enwi/LED-Christmas-Tree/README.md

# LED-Christmas-Tree
Info &amp; documentation of LED Christmas Tree Kit, a WiFi enabled Christmas Tree Soldering Kit made up of 13x APA106-F5 digitally adressable LEDs.



## Feature overview
 - 13x adressable APA106-F5 LEDs
 - Pushbutton
 - WiFi enabled (ESP8266 D1 Mini)
 - 8 different effects + effect cycling
 - Brightness control
 - Effect speed control
 - 8 different color palettes
 - WebUI
    - Change effects
    - Change color palettes
    - Change brightness
    - Change effect speed
    - Control wifi settings
    - Upload OTA updates

## Where to buy

You can get [this kit](https://www.tindie.com/products/enwi/wifi-enabled-addressable-led-christmas-tree-kit/) on my [tindie store](https://www.tindie.com/stores/enwi/#store-section-products)

## Getting started
For build instructions have a look at the [Soldering Guide](https://github.com/enwi/LED-Christmas-Tree/blob/main/soldering.md)

For uploading/updating the software have a look at the [Software Guide](https://github.com/enwi/LED-Christmas-Tree/blob/main/software.md)

There are also two videos (one English one German), which show how to build a Christmas Tree

Video English (https://www.youtube.com/watch?v=GiBtM_6d54U)

Video German (https://www.youtube.com/watch?v=HssEsnOPAMU)

## About
See the about section [here](https://github.com/enwi/LED-Christmas-Tree/blob/main/about.md)
