enwi/LED-Christmas-Tree/images/kit.JPG

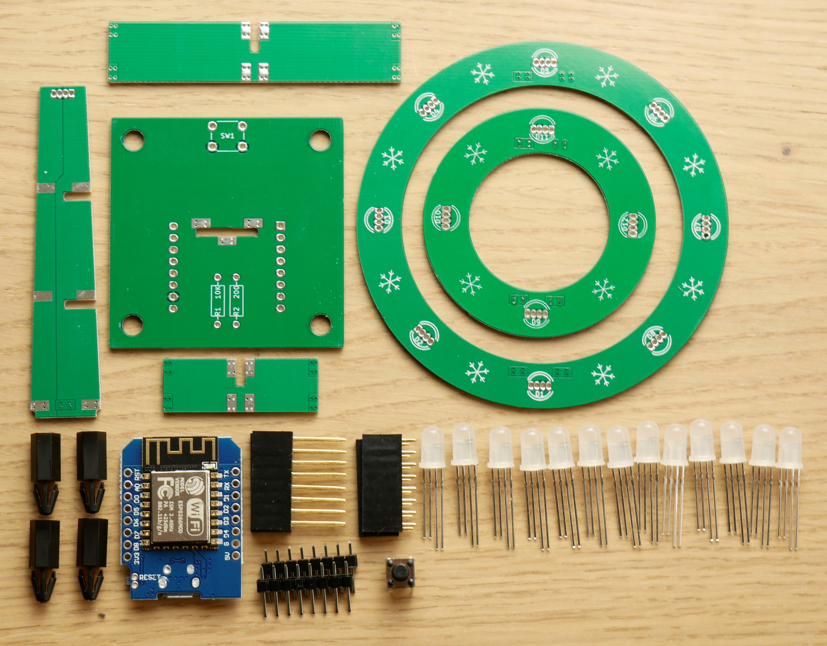
images/kit.JPG
