enwi/LED-Christmas-Tree/soldering.md

# Soldering Guide
Soldering/Putting the Christmas Tree PCB together is pretty simple, since there are not so many steps.

## 1. Assemble lower ring
1. Get the lower/larger branch and ring PCBs.
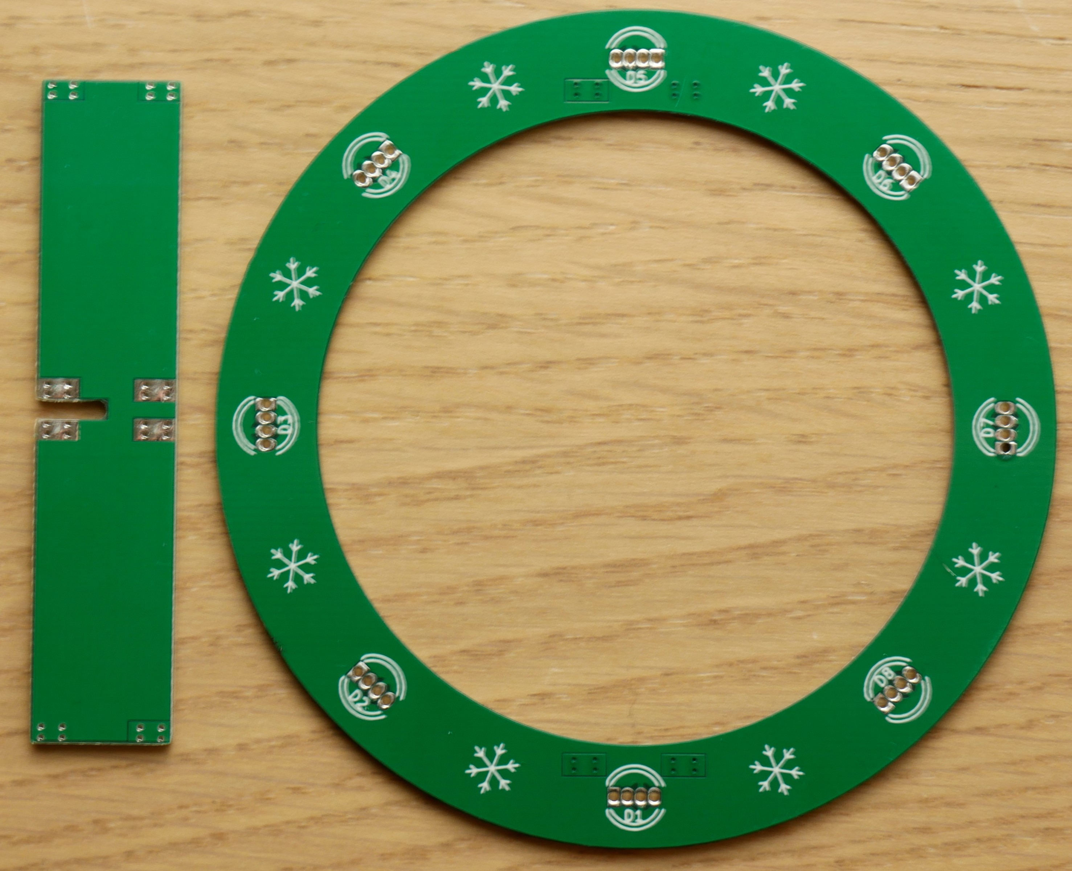
[picture p2: images/large_ring.JPG]


2. Flip the PCBs over and align the two arrows as shown in the picture.
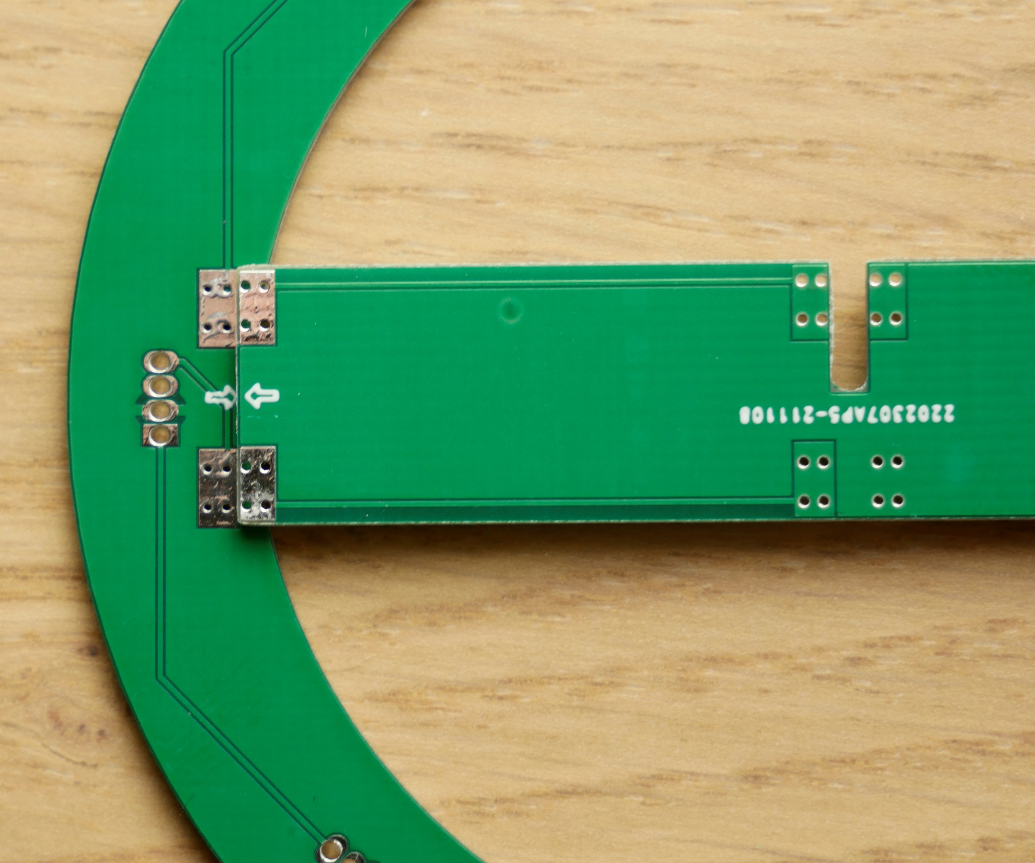
[picture p3: images/large_ring_aligned.JPG]


3. Solder the aligned pads of the two PCBs together.
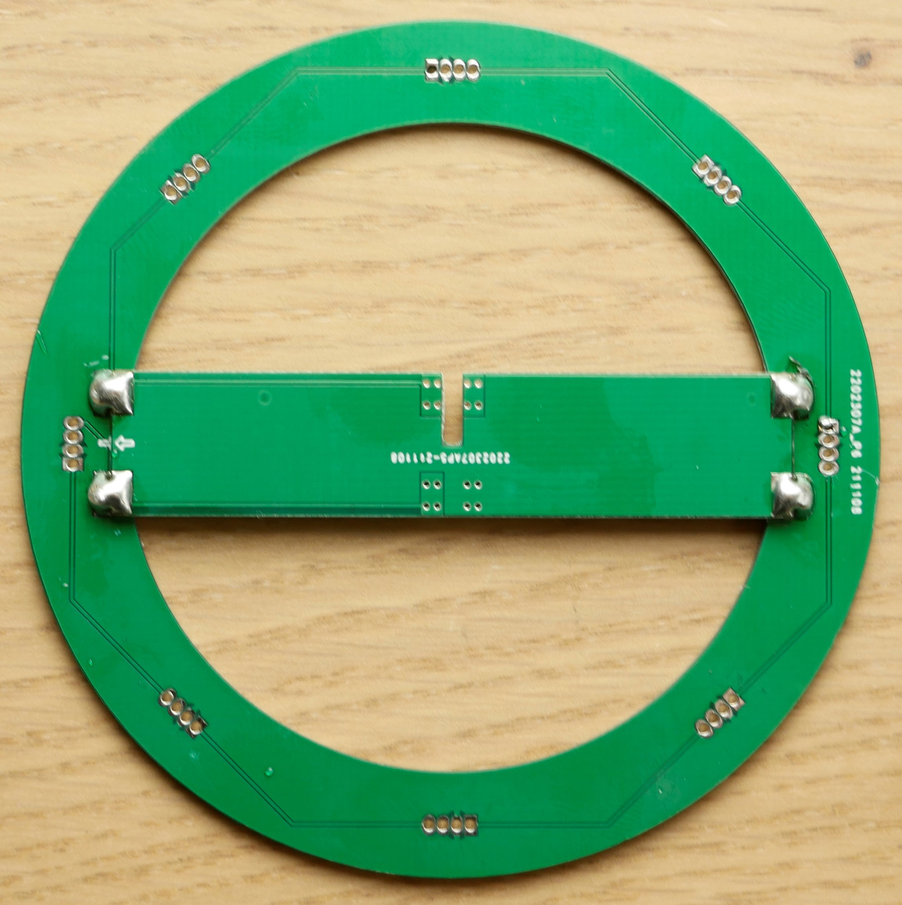
[picture p4: images/large_ring_soldered.JPG]


4. Get 8 LEDs.
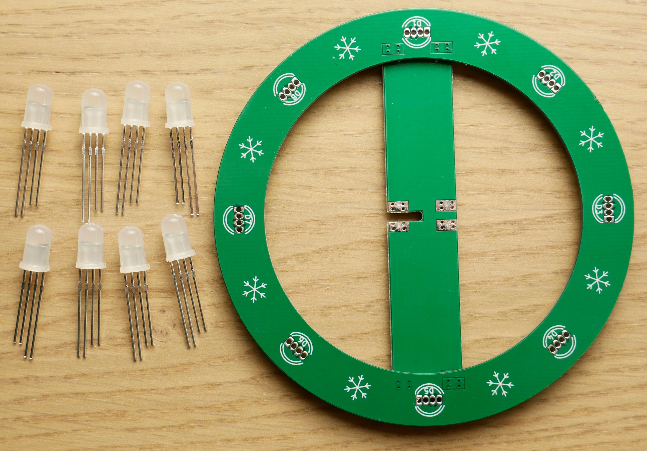
[picture p5: images/large_ring_leds.JPG]


5. Insert the LEDs as shown in the picture and marked on the PCB.
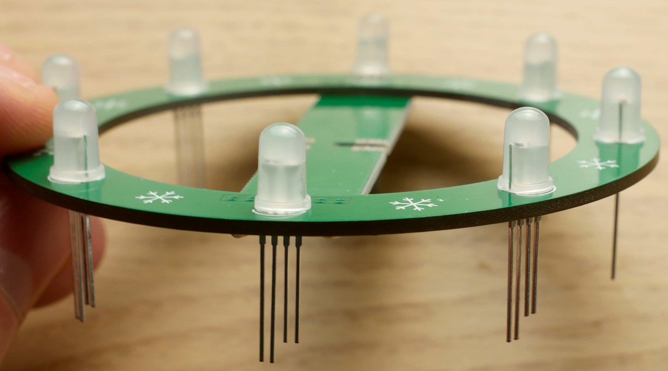
[picture p6: images/large_ring_leds_inserted.JPG]


6. Flip the ring over.
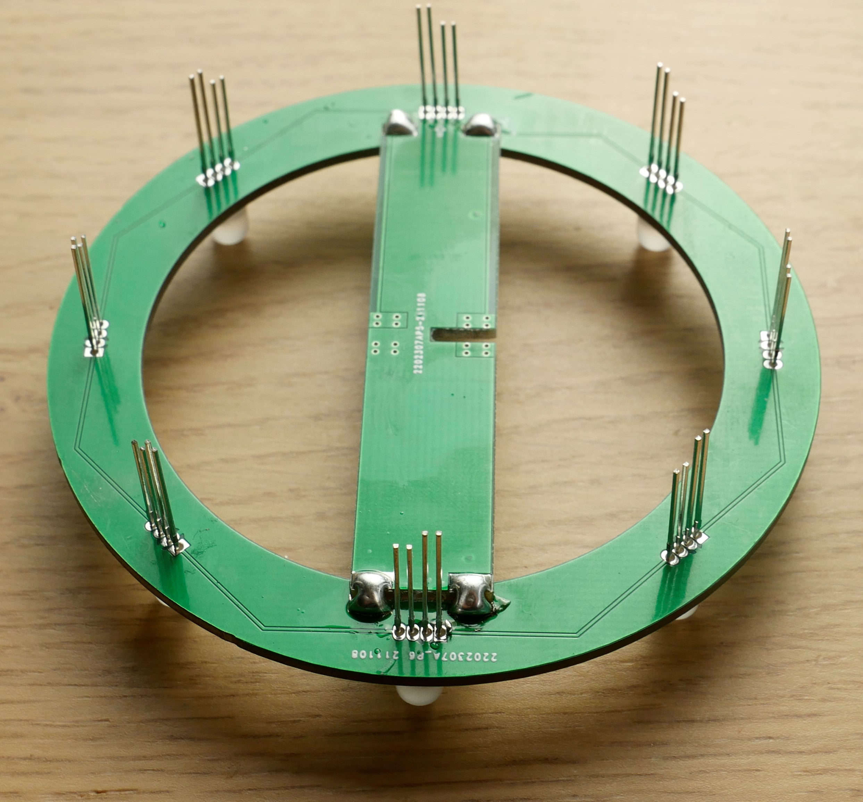
[picture p7: images/large_ring_leds_flipped.JPG]


7. Solder the LEDs and break/snip off their legs.
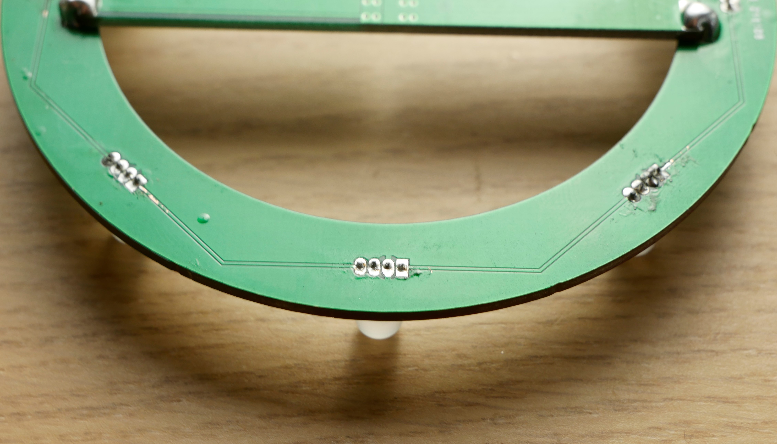
[picture p8: images/large_ring_leds_snipped.JPG]


## 2. Assemble upper ring
Repeat the steps of `1. Assemble lower ring` with the upper/smaller branch and ring PCBs.

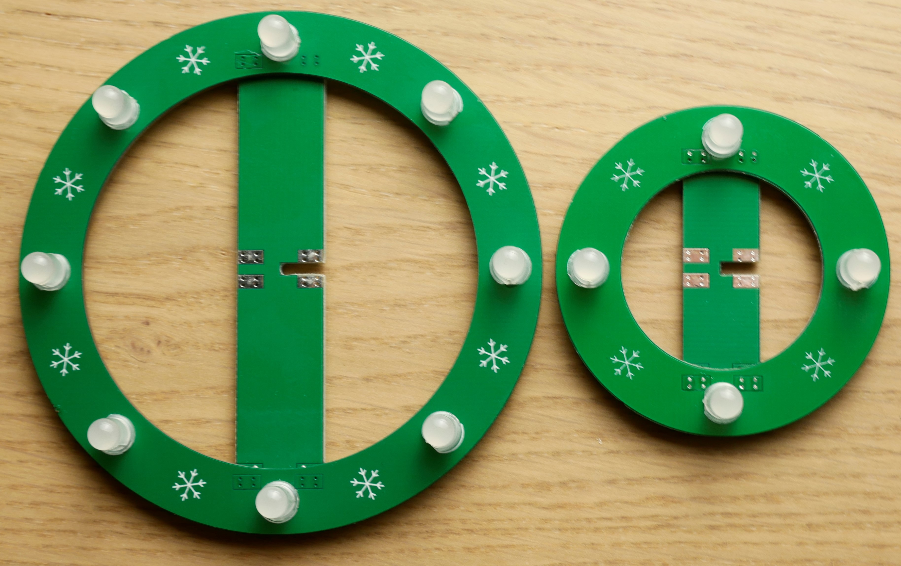
[picture p9: images/rings_assembled.JPG]


## 3. Assemble base plate
1. Get the base plate, the switch as well as the 10k and 200 ohm resistors.
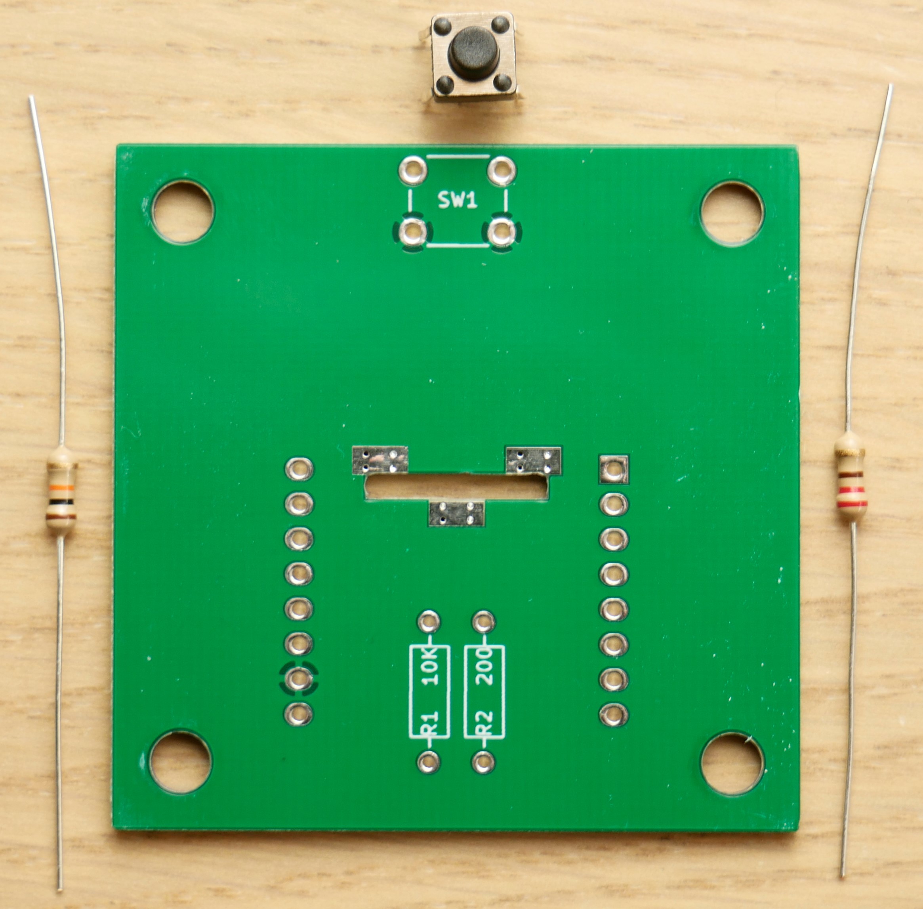
[picture p10: images/base.JPG]


2. Insert the components as marked on the PCB and solder them.
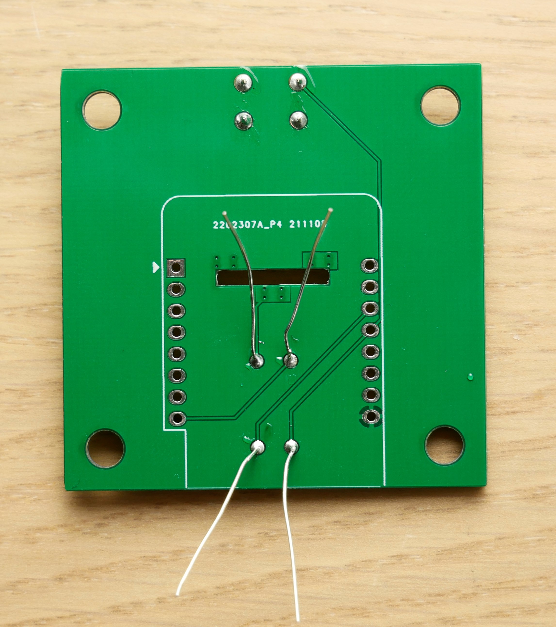
[picture p11: images/base_soldered.JPG]


3. Break/Snip off the legs of the components.
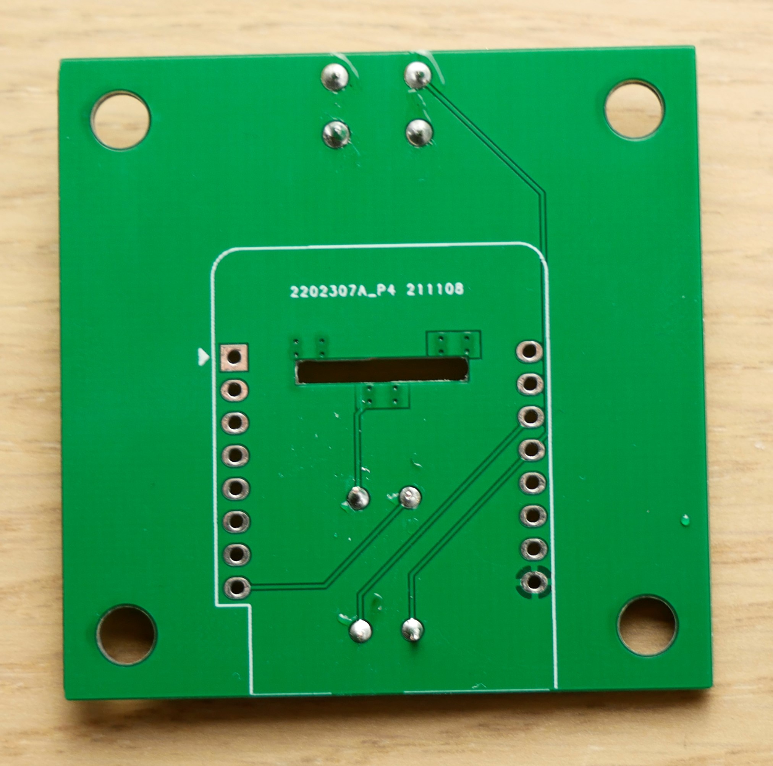
[picture p12: images/base_snipped.JPG]


4. Get the ESP8266 D1 Mini and two pin headers.
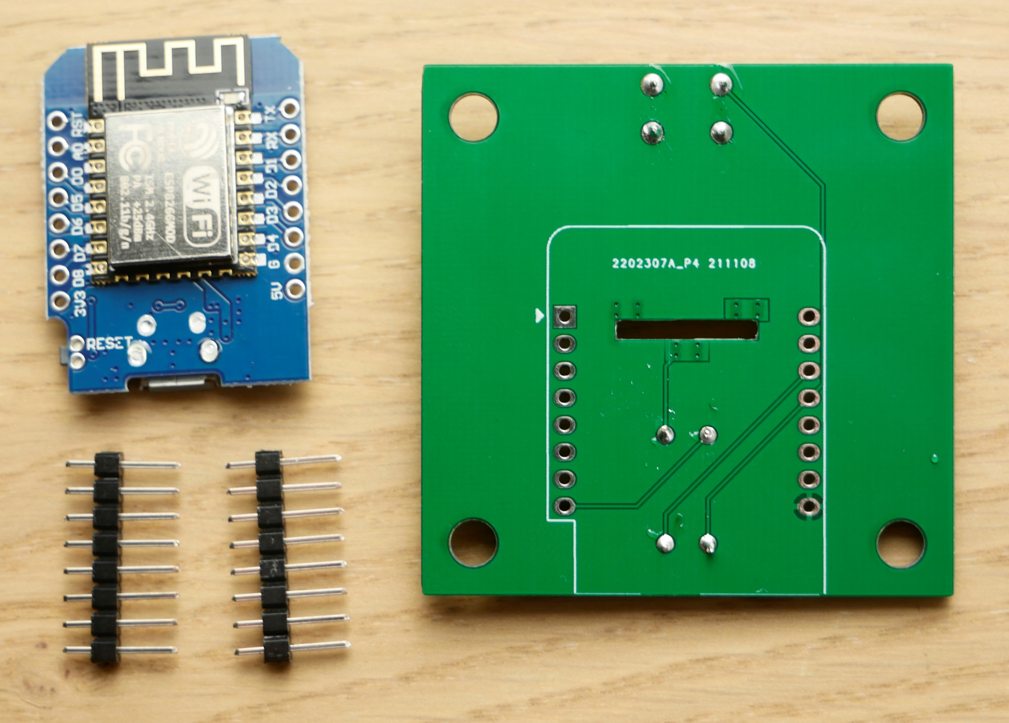
[picture p13: images/base_esp.JPG]


5. Insert the headers as seen in the picture on the bottom side (the one with the ESP8266 D1 Mini outline) of the PCB.
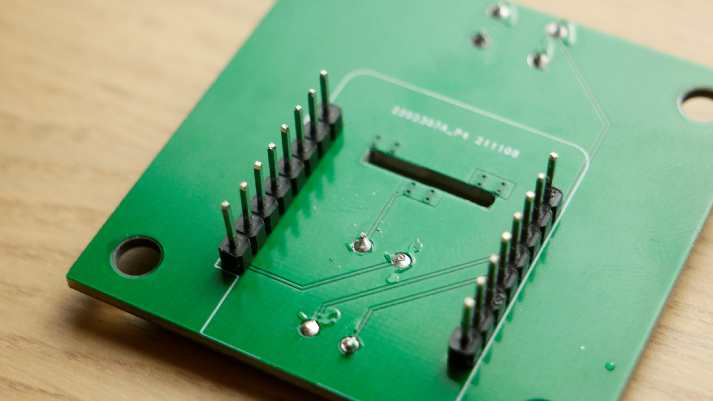
[picture p14: images/base_esp_headers.JPG]


6. Insert ESP8266 D1 Mini as seen in the picture.
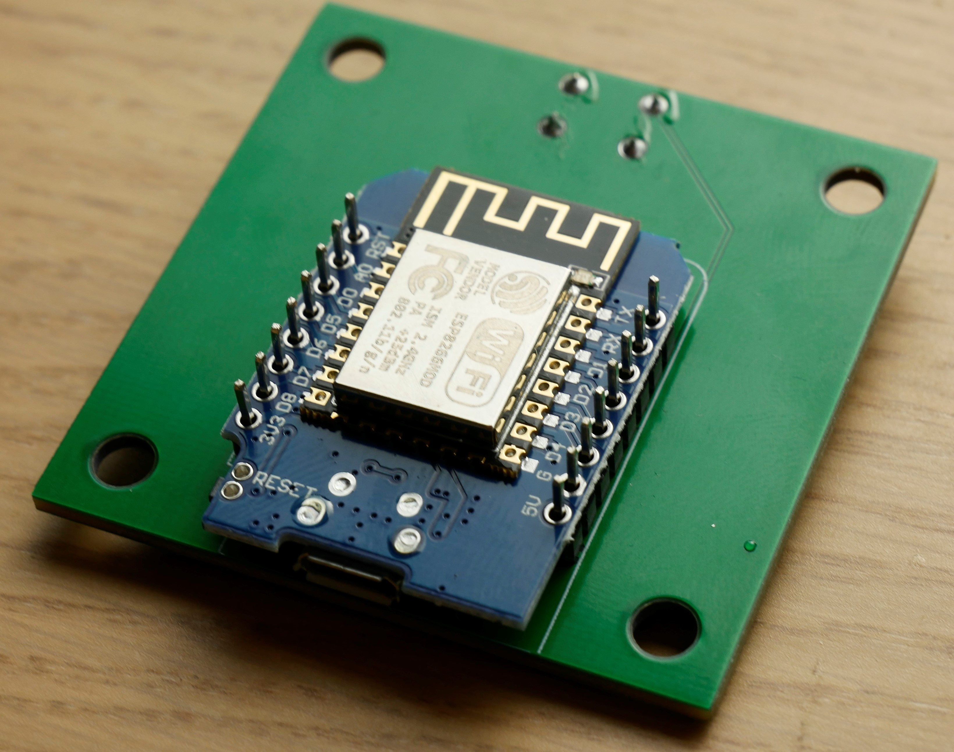
[picture p15: images/base_esp_headers_esp.JPG]


7. Flip the PCB over and solder the headers from the top.
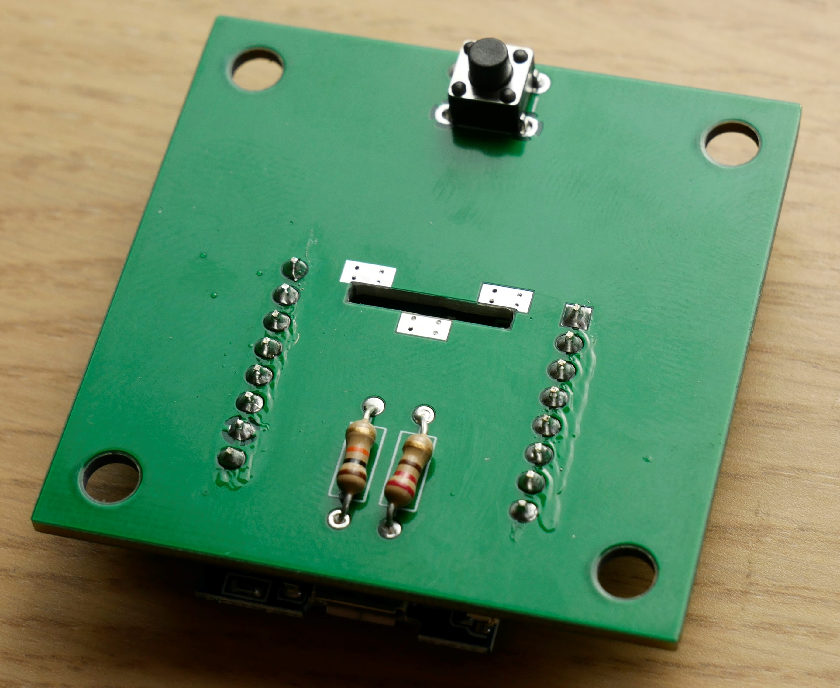
[picture p16: images/base_esp_headers_soldered.JPG]


8. Flip the PCB again and solder the ESP from the bottom while making sure that the Micro-USB does not touch the leads of the resistors.
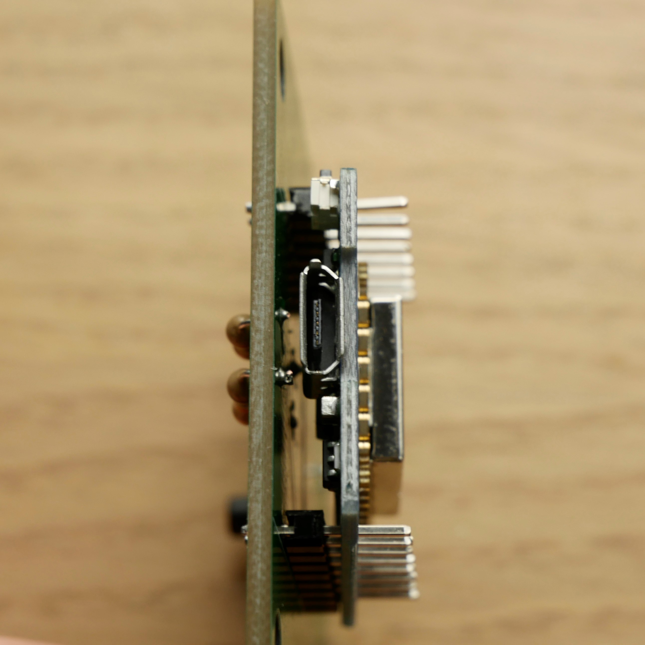
[picture p17: images/base_esp_clearance.JPG]

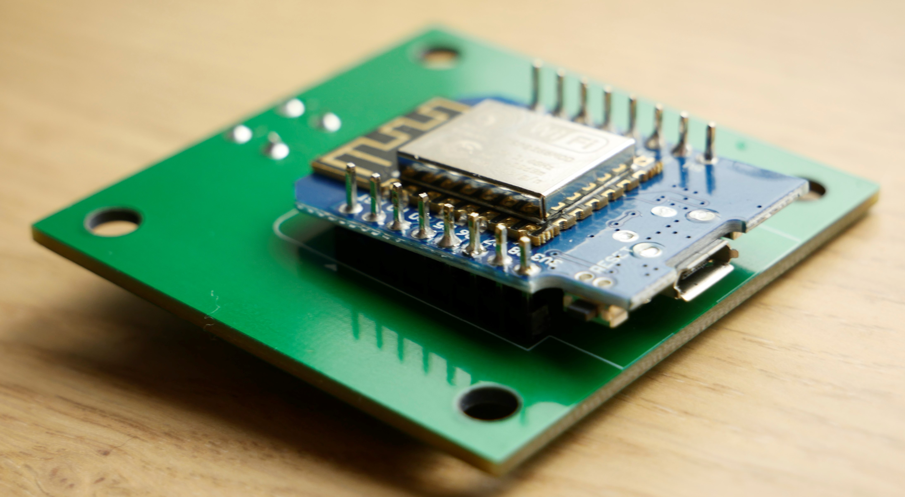
[picture p18: images/base_esp_soldered.JPG]


9. Get the plastic PCB spacers/standoffs.
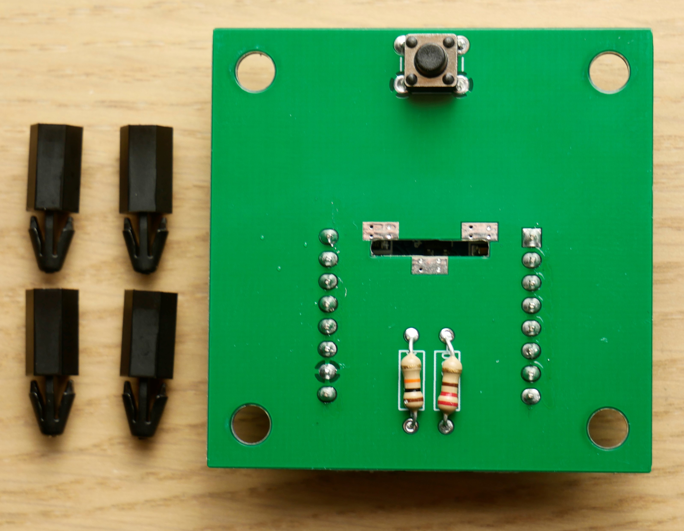
[picture p19: images/base_spacers.JPG]


10. Insert the PCB spacers/standoffs into the PCB from the bottom.
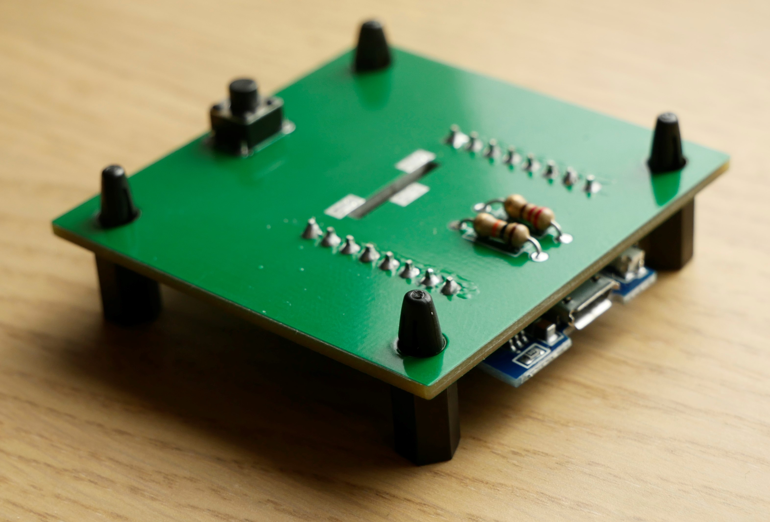
[picture p20: images/base_spacers_inserted.JPG]


## 4. Assemble tree
1. Get the tree trunk PCB.
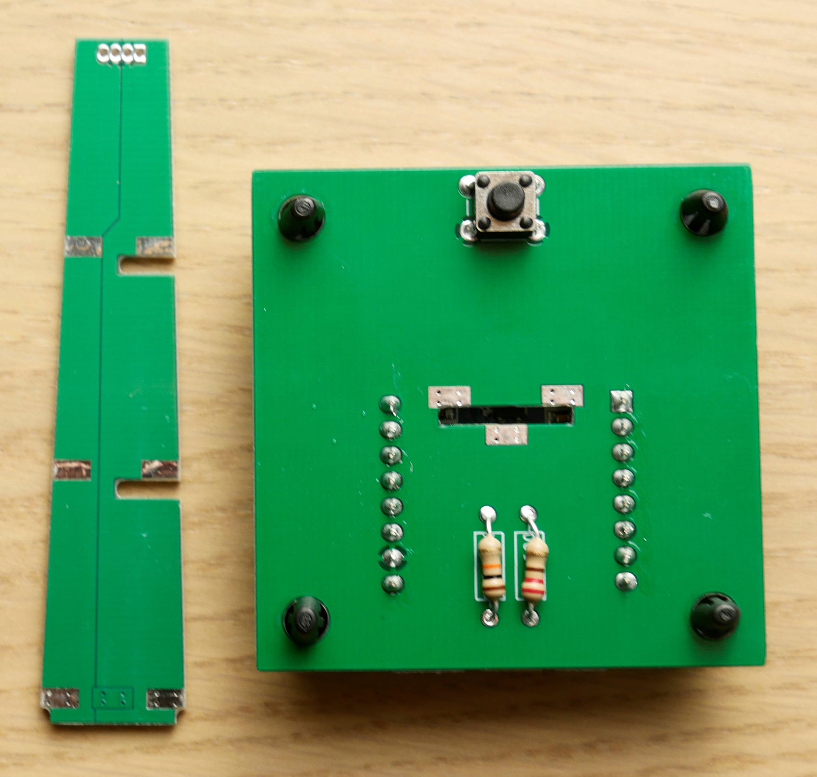
[picture p21: images/base_trunk.JPG]


2. Insert the trunk PCB into the slot of the base PCB while making sure the solder pads align.
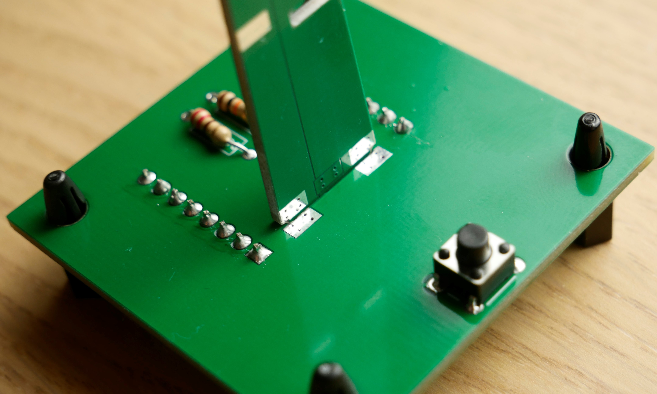
[picture p22: images/base_trunk_inserted.JPG]


3. Solder the pads of the trunk and base PCBs together while making sure the trunk is straight.
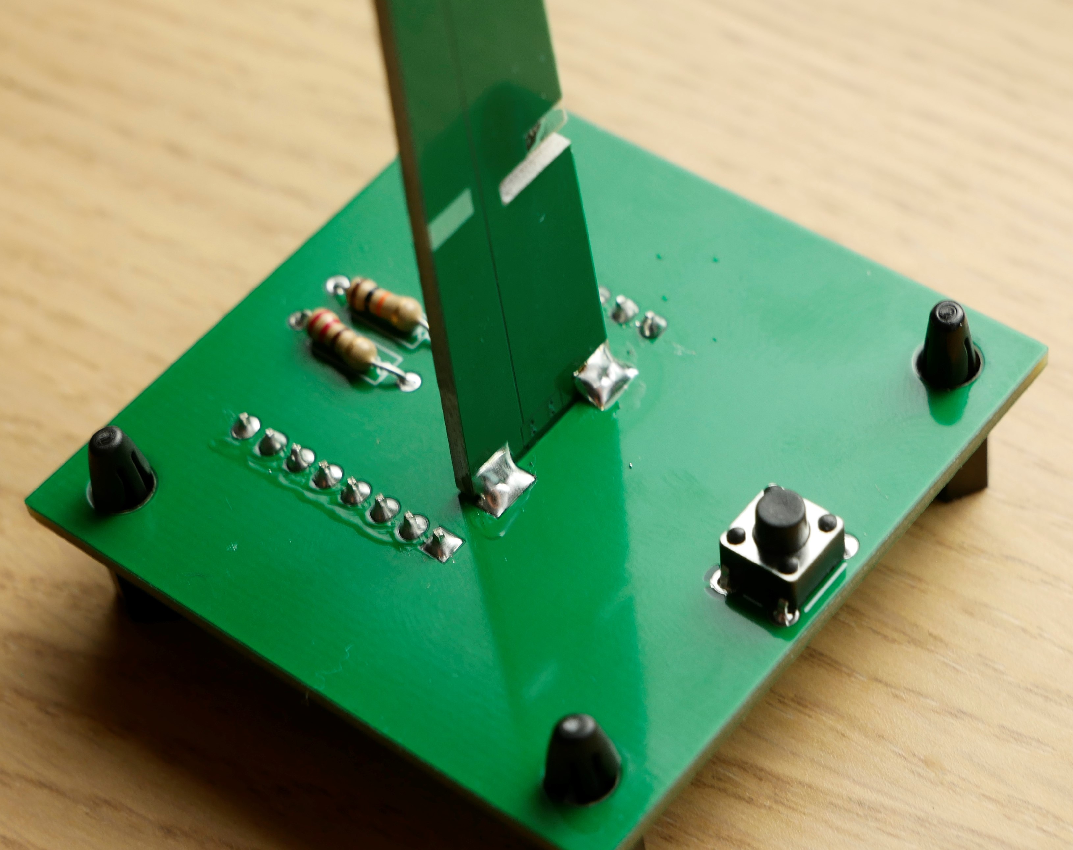
[picture p23: images/base_trunk_soldered.JPG]


4. Get the lower/larger ring and slide the branch into the trunk.
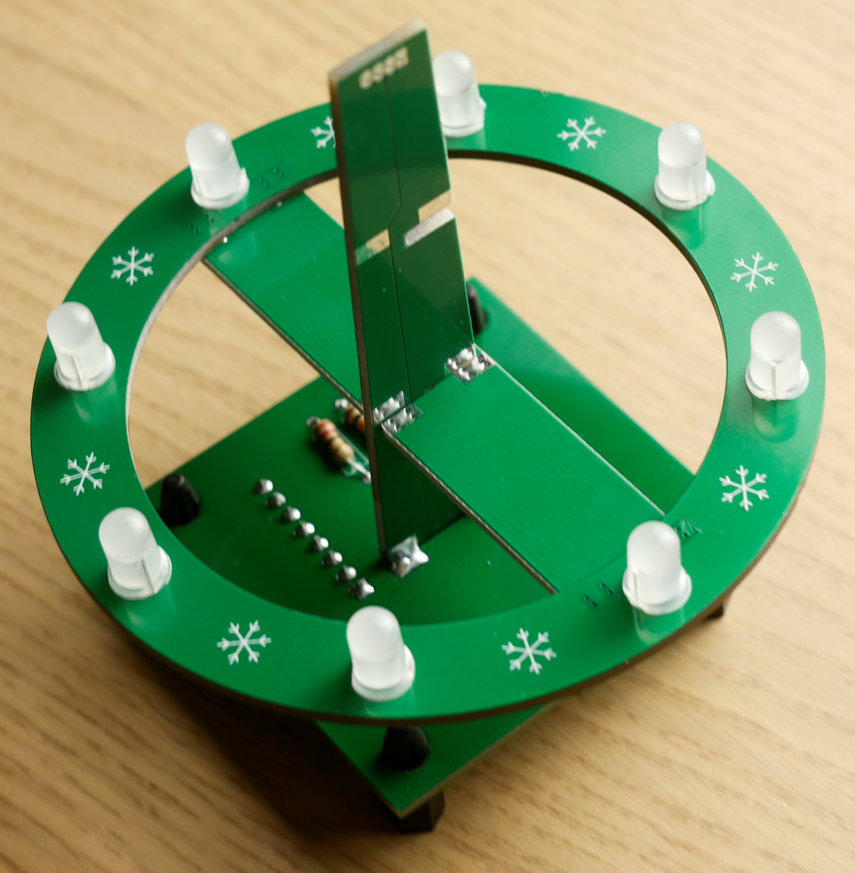
[picture p24: images/base_trunk_lower.JPG]


5. Solder the pads of the branch and the trunk PCBs together while making sure the lower/larger ring is level.
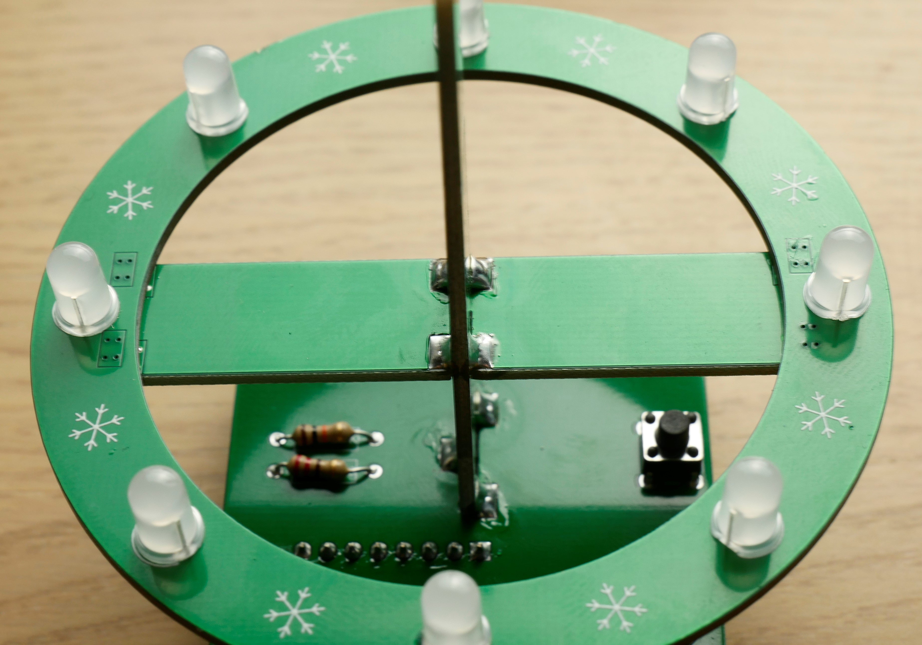
[picture p25: images/base_trunk_lower_soldered.JPG]


6. Repeat steps 4. and 5. for the upper/smaller ring.
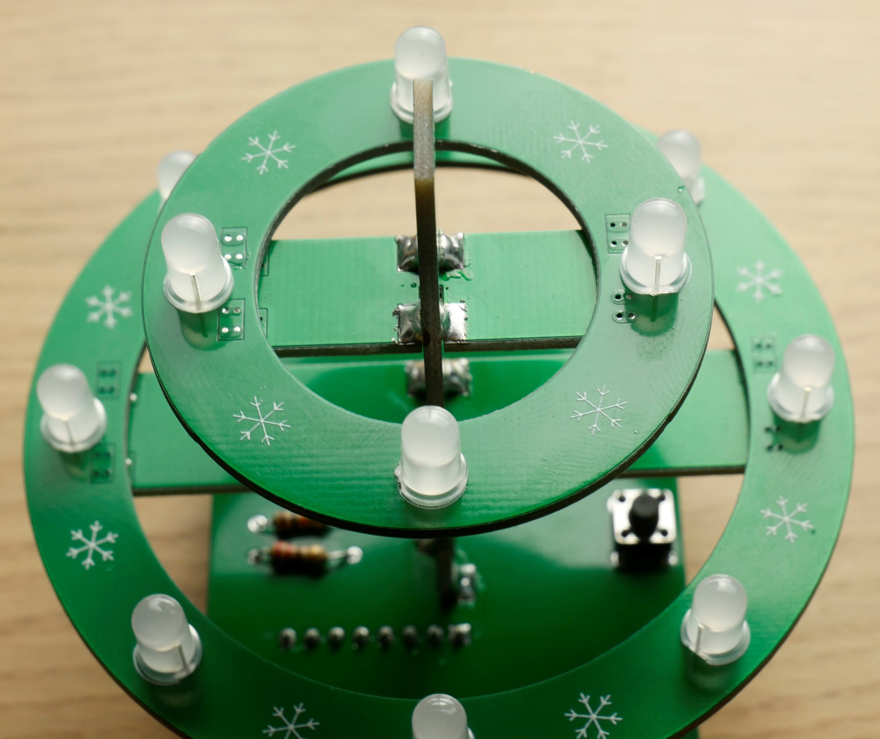
[picture p26: images/base_trunk_upper_soldered.JPG]


7. Get the last LED and insert it into the trunk PCB while leaving some space.
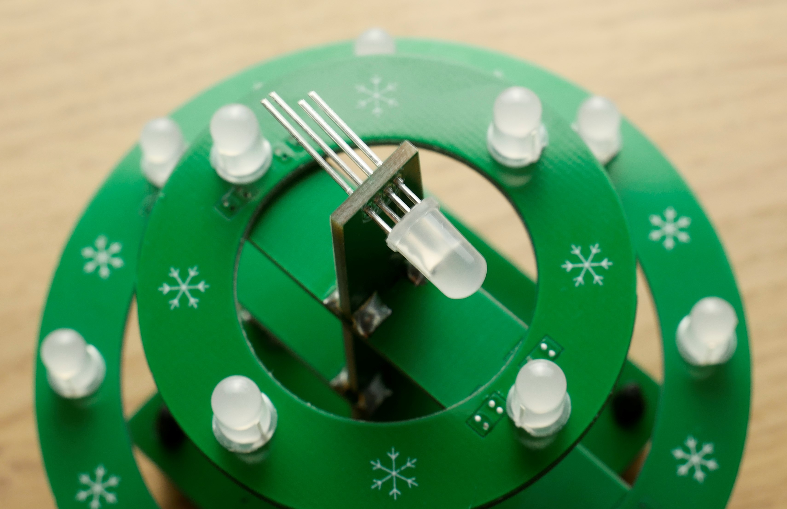
[picture p27: images/base_trunk_tip.JPG]


8. Bent the LED upwards and solder it in place.
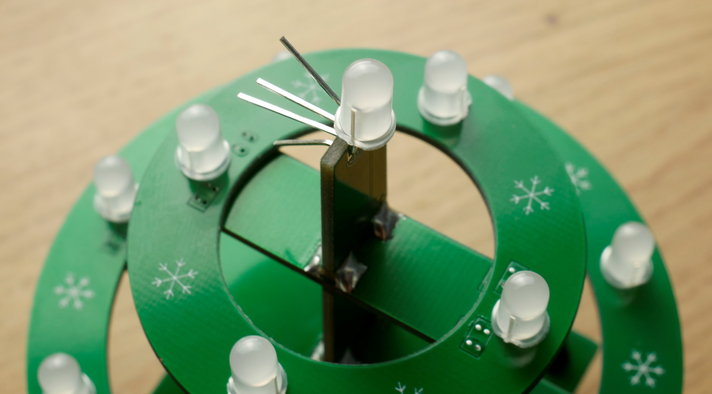
[picture p28: images/base_trunk_tip_soldered.JPG]


9. Break/Snip off the legs of the LED.
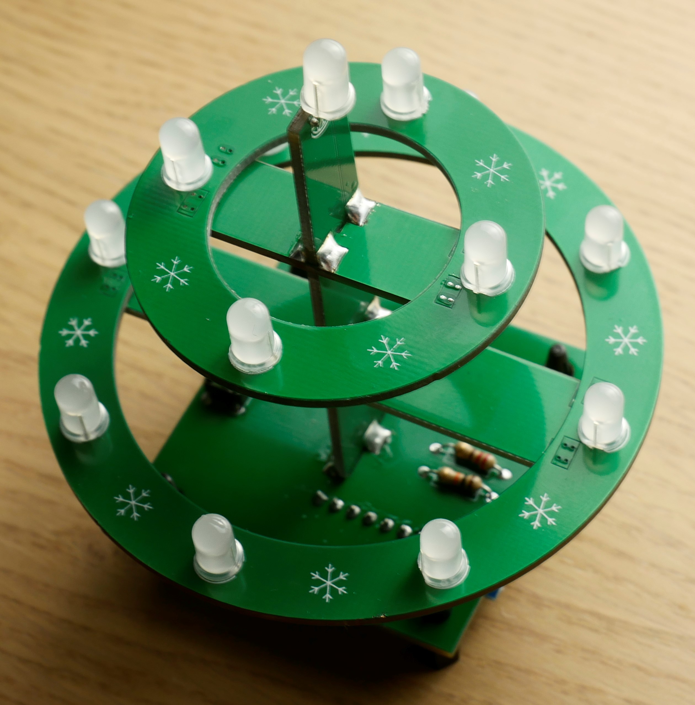
[picture p29: images/base_trunk_tip_snipped.JPG]


10. Congratulations you finished building the Christmas Tree :christmas_tree:. Now plug in the ESP8266 to your PC, upload the software described in the [Software Guide](https://github.com/enwi/LED-Christmas-Tree/blob/main/software.md) and enjoy :tada:
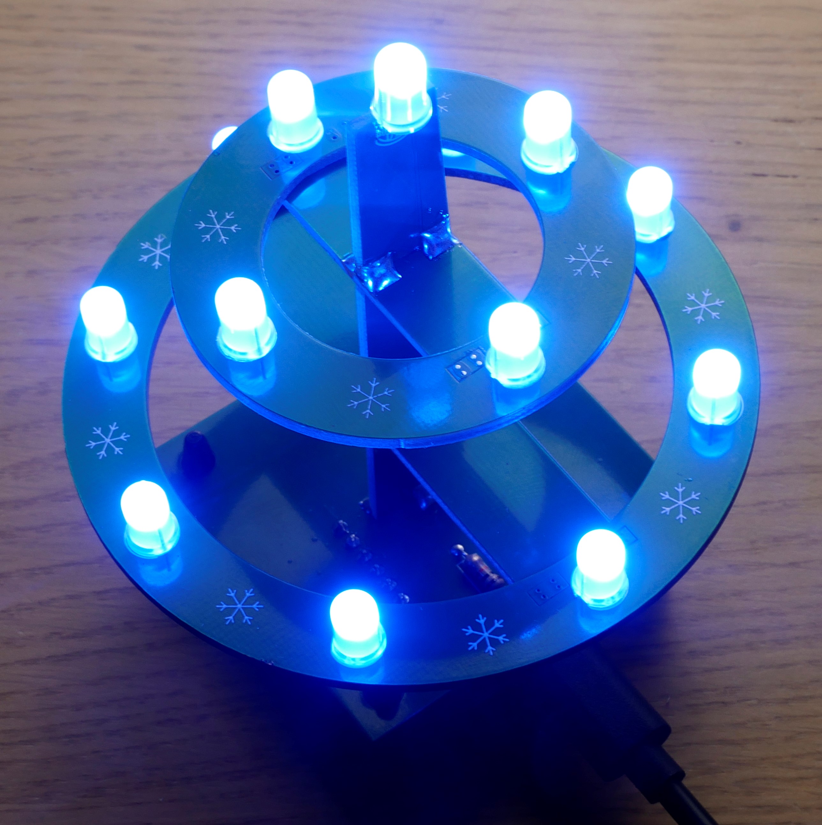
[picture p30: images/usb.JPG]
