enwi/LED-Christmas-Tree/src/Networking.cpp

#include "Networking.h"

#include "../webui/cpp/build.html.gz.h"


// ESP32 methods do not accept arduino strings
#if defined(ESP32)
#define ESP32_STR(s) s.c_str()
#else
#define ESP32_STR(s) s
#endif

void Networking::initWifi()
{
    if (isInitialized)
    {
        DEBUGLN("Wifi already initialized, should not be called again");
        return;
    }
    else if (WiFi.status() == WL_CONNECTED)
    {
        DEBUGLN("Wifi auto connected");
        isInitialized = true;
    }

    NetworkConfig& wifi = config.getNetworkConfig();

    // Does not work without issues
    // if (wifi.apEnabled && wifi.clientEnabled)
    //{
    //    WiFi.mode(WIFI_AP_STA);
    //}
    if (wifi.clientEnabled && !isInitialized)
    {
        DEBUGLN("Init wifi client");
        startClient();
    }
    else if (wifi.apEnabled)
    {
        DEBUGLN("Init wifi AP");
        startAccessPoint();
    }

    if (!config.getNetworkConfig().wifiEnabled)
    {
        config.getNetworkConfig().wifiEnabled = true;
        config.saveConfig();
    }
    isInitialized = true;
}

void Networking::initServer(TreeLight& light)
{
    server.on(
        "/ota", HTTP_POST, [](AsyncWebServerRequest* request) { request->send(200); },
        [this](AsyncWebServerRequest* request, const String& filename, size_t index, uint8_t* data, size_t len,
            bool final) { handleOTAUpload(request, filename, index, data, len, final); });

    server.on(
        "/api/status", HTTP_GET, [&light, this](AsyncWebServerRequest* request) { handleStatusApi(request, &light); });
    server.on("/api/config", HTTP_GET, [this](AsyncWebServerRequest* r) { handleConfigApiGet(r); });

    AsyncCallbackJsonWebHandler* handlerSetLeds = new AsyncCallbackJsonWebHandler("/api/set_leds",
        [&light, this](AsyncWebServerRequest* request, JsonVariant& json) { handleSetLedsApi(request, json, light); });
    server.addHandler(handlerSetLeds);

    AsyncCallbackJsonWebHandler* handlerSetConfig = new AsyncCallbackJsonWebHandler("/api/config",
        [this](AsyncWebServerRequest* request, JsonVariant& json) { handleConfigApiPost(request, json); });
    server.addHandler(handlerSetConfig);

    auto indexHandler = [this](AsyncWebServerRequest* r) { handleIndex(r); };
    server.on("/", HTTP_GET, indexHandler);
    server.on("/home", HTTP_GET, indexHandler);
    server.on("/config", HTTP_GET, indexHandler);

    // captive portal
    auto handleCaptivePortal = [this](AsyncWebServerRequest* request) { captivePortal(request); };
    // Android captive portal. Maybe not needed. Might be handled by notFound handler.
    server.on("/generate_204", HTTP_GET, handleCaptivePortal);
    // Microsoft captive portal. Maybe not needed. Might be handled by notFound handler.
    server.on("/fwlink", HTTP_GET, handleCaptivePortal);
    server.onNotFound(handleCaptivePortal);

    server.begin();
}

void Networking::stop()
{
    // server.end();
    WiFi.mode(WIFI_OFF);
    // Save off state for reboot
    config.getNetworkConfig().wifiEnabled = false;
    config.saveConfig();
    DEBUGLN("Wifi stopped");
}

void Networking::resume()
{
    WiFi.mode(config.getNetworkConfig().clientEnabled ? WIFI_STA : WIFI_AP);
    config.getNetworkConfig().wifiEnabled = true;
    config.saveConfig();
    DEBUGLN("Resuming wifi");
    if (handleClientFailsafe())
    {
        // server.begin();
        DEBUGLN("Wifi resumed");
    }
    else
    {
        DEBUGLN("Could not reconnect after resume");
    }
}

void Networking::initOrResume(TreeLight& light)
{
    if (!isInitialized)
    {
        initWifi();
        initServer(light);
    }
    else
    {
        resume();
    }
}

void Networking::getStatusJsonString(JsonObject& output)
{
    auto&& networking = output.createNestedObject("network");

    networking["mac"] = deviceMAC;

    bool client_enabled = config.getNetworkConfig().clientEnabled;

    auto&& wifi_client = networking.createNestedObject("wifi_client");
    wifi_client["status"] = client_enabled ? (WiFi.isConnected() ? "connected" : "enabled") : "disabled";
    wifi_client["ip"] = WiFi.localIP().toString();
    wifi_client["netmask"] = WiFi.subnetMask().toString();
    wifi_client["dns"] = WiFi.dnsIP().toString();

    auto&& wifi_ap = networking.createNestedObject("wifi_ap");
    wifi_ap["status"] = client_enabled ? "disabled" : "enabled";
    wifi_ap["ip"] = WiFi.softAPIP().toString();
}

void Networking::handleOTAUpload(
    AsyncWebServerRequest* request, const String& filename, size_t index, uint8_t* data, size_t len, bool final)
{
    if (!index)
    {
        DEBUGLN("UploadStart");
// calculate sketch space required for the update, for ESP32 use the max constant
#if defined(ESP32)
        if (!Update.begin(UPDATE_SIZE_UNKNOWN))
#else
        const uint32_t maxSketchSpace = (ESP.getFreeSketchSpace() - 0x1000) & 0xFFFFF000;
        if (!Update.begin(maxSketchSpace))
#endif
        {
            // start with max available size
            Update.printError(Serial);
        }
#if defined(ESP8266)
        Update.runAsync(true);
#endif
    }

    if (len)
    {
        Update.write(data, len);
    }

    // if the final flag is set then this is the last frame of data
    if (final)
    {
        if (Update.end(true))
        {
            // true to set the size to the current progress
            DEBUGLN("Update Success, \nRebooting...");
            ESP.restart();
        }
        else
        {
            Update.printError(Serial);
        }
    }
}

void Networking::handleIndex(AsyncWebServerRequest* request)
{
    AsyncWebServerResponse* response
        = request->beginResponse_P(200, F("text/html"), build_html_gz_start, build_html_gz_size);
    response->addHeader(F("Content-Encoding"), F("gzip"));
    request->send(response);
}

void Networking::handleStatusApi(AsyncWebServerRequest* request, TreeLight* light)
{
    DynamicJsonDocument output(3000);

    auto&& obj = output.to<JsonObject>();

    obj["uptime"] = millis() / 1000;
    obj["heap_free"] = ESP.getFreeHeap();

    getStatusJsonString(obj);
    mqtt.getStatusJsonString(obj);
    light->getStatusJsonString(obj);

    String buffer;
    buffer.reserve(512);
    serializeJson(output, buffer);

    request->send(200, "application/json", buffer);
}

void Networking::handleConfigApiGet(AsyncWebServerRequest* request)
{
    String buffer;
    buffer.reserve(512);
    StaticJsonDocument<1024> document;
    config.createJson(document);

    auto&& w = document["wifi"];
    w.remove("client_password");
    w.remove("ap_password");
    w["client_has_password"] = config.getNetworkConfig().clientPassword.length() != 0;
    w["ap_has_password"] = config.getNetworkConfig().apPassword.length() != 0;
    auto&& m = document["mqtt"];
    m.remove("has_password");

    serializeJson(document, buffer);

    request->send(200, "application/json", buffer);
}

void Networking::handleConfigApiPost(AsyncWebServerRequest* request, JsonVariant& json)
{

    DEBUGLN("Received new config");

    JsonObject&& data = json.as<JsonObject>();

    NetworkConfig& wifi = config.getNetworkConfig();
    bool changed = wifi.tryUpdate(data["wifi"]);

    MqttConfig& mqtt = config.getMqttConfig();
    changed |= mqtt.tryUpdate(data["mqtt"]);

    if (changed)
    {
        config.saveConfig();
    }
    else
    {
        DEBUGLN("Config did not change");
    }

    AsyncWebServerResponse* response = request->beginResponse(200, "text/plain", "OK");
    request->send(response);

    if (changed)
    {
        restartESP = true;
    }
}

void Networking::handleSetLedsApi(AsyncWebServerRequest* request, JsonVariant& json, TreeLight& light)
{
    AsyncResponseStream* response = request->beginResponseStream("text/html");
    JsonObject&& data = json.as<JsonObject>();
    light.setBrightnessLevel(data["brightness"]);
    light.setSpeed(static_cast<Speed>((uint8_t)data["speed"]));
    light.setEffect(static_cast<EffectType>((uint8_t)data["effect"]));
    light.setColorSelection((uint8_t)data["color"]);
    response->print("OK");
    request->send(response);
}

bool Networking::isIp(const String& str)
{
    for (size_t i = 0; i < str.length(); i++)
    {
        int c = str.charAt(i);
        if (c != '.' && (c < '0' || c > '9'))
        {
            return false;
        }
    }
    return true;
}

bool Networking::shouldEnableWifiOnStartup()
{
    return config.getNetworkConfig().wifiEnabled;
}

void Networking::update()
{
    // handle DNS
    dnsServer.processNextRequest();

    if (restartESP)
    {
        ESP.restart();
    }
}

bool Networking::captivePortal(AsyncWebServerRequest* request)
{
    if (ON_STA_FILTER(request))
    {
        // DEBUGLN(F("Captive STA Filter"));
        return false; // only serve captive portal in AP mode
    }
    if (!request->hasHeader("Host"))
    {
        // DEBUGLN(F("Captive Host header missing"));
        return false;
    }
    const String hostHeader = request->getHeader("Host")->value();
    if (isIp(hostHeader) || hostHeader.indexOf(HOSTNAME) >= 0)
    {
        // DEBUG(F("Captive Host Filter: "));
        // DEBUGLN(hostHeader);
        return false;
    }

    DEBUGLN(F("Captive portal"));
    AsyncWebServerResponse* response = request->beginResponse(302);
    response->addHeader(F("Location"), F("http://192.168.4.1"));
    request->send(response);
    return true;
}

bool Networking::handleClientFailsafe()
{
    unsigned long start = millis();
    while (WiFi.status() != WL_CONNECTED)
    {

        DEBUG('.');
        // TODO: Make async and remove delay
        delay(1000);
        if (millis() - start > 15000)
        {
            DEBUGLN();
            DEBUGLN("Failed, enabling AP");

            startAccessPoint(false);
            return false;
        }
    }
    return true;
}

void Networking::startClient()
{
    DEBUGLN("Using wifi in client mode");

    const NetworkConfig& wifi = config.getNetworkConfig();

    if (!wifi.dhcpEnabled)
    {
        DEBUGLN("Using static ip");
        if (!WiFi.config(wifi.clientIp, wifi.clientGateway, wifi.clientMask, wifi.clientDns))
        {
            DEBUGLN("STA Failed to configure");
        }
    }
    else
    {
        DEBUGLN("Using DHCP");
    }

    WiFi.persistent(true);
    WiFi.mode(WIFI_STA);
    WiFi.begin(ESP32_STR(wifi.clientSsid), ESP32_STR(wifi.clientPassword));
    DEBUG("Connecting to WiFi ..");

    if (handleClientFailsafe())
    {
        DEBUG("Connected: ");
        DEBUGLN(WiFi.localIP());

        WiFi.setAutoConnect(false);
        WiFi.setAutoReconnect(true);
    }
}

void Networking::startAccessPoint(bool persistent)
{
    const NetworkConfig& wifi = config.getNetworkConfig();

    DEBUGLN("Using wifi in ap mode");

    WiFi.persistent(persistent);

    WiFi.mode(WIFI_AP);
    WiFi.softAPConfig(AP_IP, AP_IP, AP_NETMASK);

    if (wifi.apPassword.length() == 0)
    {
        WiFi.softAP(ESP32_STR(wifi.apSsid));
        DEBUGLN("Starting open AP");
    }
    else
    {
        WiFi.softAP(ESP32_STR(wifi.apSsid), ESP32_STR(wifi.apPassword));
        DEBUGLN("Starting protected AP");
    }

    // captive portal
    DEBUGLN("Starting DNS server");
    dnsServer.setErrorReplyCode(DNSReplyCode::NoError);
    dnsServer.start(53, "*", WiFi.softAPIP());
}
