enwi/LED-Christmas-Tree/(commit log)

2021-11-28 Add instructions for ring assembly
2021-11-28 Finish soldering guide
2021-11-28 Fix emote in soldering guide
2021-11-28 Add crude sample code.
2021-11-28 Add VSCode arduino.json
2021-11-28 Fix code to run on D1 Mini
    [code.ino]
2021-12-01 Fix and format code
    [TreeLight.cpp, code.ino]
2021-12-01 Change LED type to APA106 and order to RGB
2021-12-03 Add OTA via AccessPoint
    - Remove unused code
    - Improve button handling and add placeholders for visual menu
    - Make animation speed changeable with double click
    - Make AccessPoint toggable with 3 second long press
    - Add Networking.h/.cpp for WiFi and future networking
    - Add Constants.h/.cpp for constants and other global constantish variables
2021-12-03 Add file type filter to OTA upload
2021-12-03 Fix wrong pixel GPIO
    - Fix type mismatches
    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
    [TreeLight.cpp, TreeLight.h, code.ino]
2021-12-03 Fix fading on running light, double its speed.
    [TreeLight.cpp]
2021-12-04 Fix ifdef and generalize it
    - Call FastLED.show() as often as possible
    - Reformat code
    [Menu.cpp, Networking.cpp, TreeLight.cpp, TreeLight.h, code.ino]
2021-12-04 Fix reentering brightness menu after single press
    [Menu.cpp, code.ino]
2021-12-05 Fix running light overflow, add debug Serial output.
    [TreeLight.cpp, TreeLight.h, code.ino]
2021-12-05 Detect longer button presses for clicking.
2021-12-08 Fix click detection when leaving menu.
    The button release was detected as another click.
    [Menu.cpp, Menu.h, code.ino]
2021-12-11 Fix twinkle fox flickering and reduce its speed.
    [TreeLight.cpp]
2021-12-13 Replaced the api enable by the effect
    [Networking.cpp, TreeLight.cpp, TreeLight.h]
2021-12-13 Enforce correct code style
    [Constants.h, Mqtt.h, Networking.cpp, Networking.h, TreeLight.cpp, TreeLight.h, code.ino]
2021-12-13 Force add esp8266 to board manager
2021-12-13 Fix compilation for non FS boards
2021-12-23 Fix compilation on Arduino
    [code.ino]
2022-01-10 Fix red and green similar color generation.
    [TreeColors.cpp]
2022-02-01 Fix json memory leaks
    [Networking.cpp]
2022-02-01 Do not print config file when saving, use ESP8266 hardware RNG for seeding.
2022-02-01 Remove arduino:avr from test workflow
    - unclutter workflows
2022-02-01 Remove Arduino compile ifdefs.
2022-02-01 Fix wifi restart for esp core 2.74
    [Networking.cpp, code.ino]
2022-02-01 Implement saving current effect state.
2024-11-22 Fix build errors for esp8266 and esp32
    [Config.cpp, Networking.cpp, Networking.h, TreeLight.cpp, code.cpp]
